dadalangx/neptune4max-autoprep/docs/hardware.md

**简体中文** | [English](hardware.en.md)

# 硬件与独立双 Z

准备配件和实际拆装前，先看[采购清单与装配步骤](bom-and-assembly.md)。这里保留驱动参数、引脚、参考几何与实物照片，供适配和标定时查阅。

## 已验证的组合

海王星 4 Max、ZNP K1 V2.0、MKS TMC2209 V2.0。两颗大采样电阻为 R110 时，电阻值是 **0.110Ω**，不是 110Ω，也不应把两颗相加为 0.220Ω。两颗分别服务电机相电流采样。

本机 E1 使用 UART 跳线，M0/M1/M2 开路，地址 0；`run_current: 0.6` 保持既有数值，`stealthchop_threshold: 0`。0.6A 是本机参考 RMS 电流，不是此驱动额定能力或所有电机的推荐值。核对实际模块版本、电阻丝印和插入方向，不能只凭芯片名称。

E1 跳线位置见实物图：**只短接 UART，M0/M1/M2 均留空**。照片为了展示跳线未插驱动模块，完成安装时需正确插入 MKS TMC2209 V2.0。

E1 UART 跳线设置实物

| 主板位置 | STEP | DIR | ENABLE | UART | 当前逻辑职责 |
|---|---|---|---|---|---|
| 原 Z | PC10 | PA13 | PC11 | PC5 | `stepper_z` |
| 新增 E1 | PB1 | PB2 | PB0 | PB6 | `stepper_z1` |
| E0 | PA5 | PA6 | PA4 | PC4 | 原挤出机；保留 |
| FAN2 | PB7 | — | — | — | 主模型风扇 |
| FAN3 | PC9 | — | — | — | 独立辅助模型风扇 |
| FAN4 | PA8 | — | — | — | 驱动专用散热风扇 |
| FAN1 / FAN6 | PC7 | — | — | — | 共用控制输出；改装后仅保留热端散热风扇 |

表格是不带取反符号的物理引脚。参考配置原 Z 为 `dir_pin: PA13`，E1 为 `dir_pin: !PB2`，使此前观察到的两侧正向运动均抬升；目标机器取反符号按实测设置。

## 装配

拆除 Z 同步皮带及丝杆顶部的两个同步带轮，使两侧可独立运动。将原来并联的电机线拆开，分别压接到原 Z 和 E1。保留每台电机的两组线圈配对，检查端子压接和接触，不按线色推断相序。断电后进行驱动、跳线和电机插拔。驱动需要散热片与主板风道。

辅助模型散热风扇复用海王星 4 Max 自带的风扇，无需另购，独立接 FAN3；匹配原接口的电压和极性，线长或接头不合适时按需准备配套线材。不能与 PB7 主风扇共用同一控制输出而期望 `P2` 单独调速。

驱动散热风扇从 FAN6/PC7 移到 **FAN4/PA8**。FAN1 与 FAN6 共用 PC7，将驱动风扇独立出来后，不再依赖热端温度启动。保持 FAN1 热端散热设置，检查 PA8 没有被其他配置占用，再合并 [driver_cooling.cfg](../config/reference/driver_cooling.cfg)。风扇、电机或模块接线均需先断电。

使用**拓竹 A1 适用的硅胶擦嘴条**，安装在**热床接线末端的塑料支架上**，位置参考下图。这类配件容易购买；不要把照片的目测位置当成坐标标定。实施者仍应测量自己的接触位置、高度、工具头间隙和全程行程，再生成擦嘴路径。

拓竹 A1 硅胶擦嘴条安装位置

## 左右映射及自动调平坐标

面对打印机正面定义左右。机主已确认参考机器为**原 Z 控制左侧，E1 控制右侧**。其他机器可能采用不同接法，**左右接线必须实测确认**：智能体应让机器旁的改装者观察小幅低速分轴测试，记录每个通道实际控制哪一侧以及正向是否抬升，不能直接套用参考机器的侧别。

这些运动测试必须遵守[上电/重启后的真实归位规则](validation.md#上电与重启后的归位规则)：先具备安全归位条件并完成真实G28，再进行后续XYZ运动。新增接线方向或空间条件尚不能确认时，先让用户检查，不能信任启动默认坐标或盲目归位。

`z_positions` 的第一行对应 `stepper_z`，第二行对应 `stepper_z1`。[Klipper 配置说明](https://www.klipper3d.org/Config_Reference.html#z_tilt)定义了这个顺序。正向抬升及实际运动侧必须先验证，再使用 Z_TILT；接反顺序会朝错误方向校正。

本机丝杆中心距实测 480 mm。绝对 X 原点未实测，历史参考用 430 mm 床宽居中估计为 -25 与 455；它们不是量产机械图纸尺寸。

| 观察到的映射 | `z_positions` 第一行 | 第二行 |
|---|---|---|
| 原 Z 左、E1 右 | `-25, 215` | `455, 215` |
| 原 Z 右、E1 左 | `455, 215` | `-25, 215` |

上表仅演示顺序，两列的数值仍需目标机器测量。回归测试没有替代电机接线和坐标验证。

六个探点是**喷嘴坐标**：左列 X70，右列 X400，Y184.55/194.55/204.55，采用蛇形顺序。对应参考 PA11 探针位置 X45.75/375.75，Y205/215/225，因为探针偏移为 X-24.25/Y+20.45。左右各三个点集中在中间约 20 mm 范围，避免前中后跨度过大。

## 排错入口

UART 无响应时先核对断电安装、插入方向、实际有无驱动、电阻/模块型号、UART 与 M0/M1/M2 跳线、PB6、地址 0 和供电。用 `DUMP_TMC STEPPER=stepper_z1` 判断通信，**通信成功不等于电机相序、侧别或方向正确**。未经确认不要反复执行归零或倾斜调整。

厂家资料：[MKS TMC2209 官方硬件说明](https://github.com/makerbase-mks/MKS-StepStick-Driver/tree/master/MKS%20TMC2209)。该资料说明的是模块本身；ZNP K1 的 UART 跳线组合来自机主这套实际组合的验证，不是所有主板的通用跳线规则。

## 接线和引脚参考图

原厂主板接线图，可用于识别电机、探针、加热器和风扇接口：

原厂主板接线图

ZNP K1 V2.0 引脚布局图，可用于核对 E1 的 PB6 UART、FAN4 的 PA8，以及 FAN1/FAN6 的共用 PC7 输出。原附件名称为“主板原理图”，图中展示的是引脚与接口布局：

ZNP K1 V2.0 主板引脚布局图
