dadalangx/neptune4max-autoprep/skills/neptune4max-mods/references/hardware-and-geometry.md

# 硬件和几何决策

准备采购或指导装配时读[采购清单与具体装配](../../../docs/bom-and-assembly.md)，按所选功能和目标机现状确认数量。4P胶壳/端子按实际重做的插头数计算，接口规格以匹配原插座为准；不要把市场“XH2.54”名称当作JST XH标称间距。辅助模型散热和驱动散热风扇均复用原厂件，按需准备改接线材。

适用基板是ZNP K1 V2.0。原Z: STEP PC10、DIR PA13、ENABLE PC11、UART PC5。E1: PB1、PB2、PB0、PB6。E0 PA5/PA6/PA4/PC4是挤出机，不分配给Z。

指定已用模块MKS TMC2209 V2.0；两颗R110各0.110Ω，不合并电阻；UART跳线闭合，M0/M1/M2开路，地址0。按实际模块而不是芯片家族核对。参考E1 dir_pin !PB2、原Z PA13、enable均取反、16细分、rotation_distance8、0.6A、threshold0；方向与电流不当成每台通用参数。

断电完成驱动、电机和跳线插拔，检查模块方向、供电、相线和压接。两根丝杆去掉同步皮带及顶部同步带轮后才可独立调节。

参考机器已由机主确认原Z控制正面左侧、E1控制右侧。复刻目标的接法可能不同：必须让机器旁的用户观察分别驱动的小幅低速测试，确认两个通道实际侧别和正向抬升后填写z_positions；观察不清不可猜，不因已有参考映射而跳过验证。

XYZ测试也受每次启动先真实归位的规则约束：先确认安全归位条件并完成本次启动的真实三轴G28，再执行后续分轴运动。未知接线方向、探针或空间条件应先由用户检查，不能信任默认坐标或盲目G28。详见项目docs/validation.md。

z_positions第一行对应stepper_z，第二行对应stepper_z1。参考间距480mm，原点用430床宽居中估计-25与455而非实测。参考探点喷嘴X70/400、Y184.55/194.55/204.55；探针偏移X-24.25/Y+20.45。范围、坐标原点和两侧机械位置需要目标校准。

FAN2 PB7为主[fan]，max_power0.70；FAN3 PC9独立auxiliary_fan，max_power1。M106默认/P0/P1主，P2辅助；M107无P关闭两者。仅改接线而没有P2宏路由或切片非零辅助风扇设置，不能完成Bambu控制。

FAN4 PA8为驱动专用controller_fan，原驱动风扇从FAN6 PC7移入。FAN1/FAN6共用PC7，保留热端heater_fan。监控X/Y/Z/Z1/挤出机使能，100% PWM，全部释放后延时60秒停；Z保持锁定时持续转是预期，不由M107关闭。空heater列表的旧版兼容见软件参考。

擦嘴条使用拓竹A1适用硅胶条，安装在热床接线末端塑料支架上；实物与UART跳线照片、两张接线/引脚参考图见项目docs/hardware.md。X10～30/Y430/Z-0.5、-2offset、高速200mm/s是参考路径。目标未测接触位置、高度或间隙时不要执行；生成自己的范围和接触高度。丝杆校准、清洁和耐高温胶带床高微调属于机械维护，不是固件自动矫直能力。
