dadalangx/neptune4max-autoprep/skills/neptune4max-mods/SKILL.md

---
name: neptune4max-mods
description: Adapt or troubleshoot the Neptune 4 Max ZNP K1 V2.0 modification project, including independent Z, ADXL nozzle offset, wiping, adaptive mesh with reference drift correction, Bambu fans and old Python compatibility. Use for this project’s replication or maintenance.
---

# Neptune 4 Max 改装接手

把本项目作为已使用改装机的工程参考，按用户所选功能适配目标机器。它不是经过原装全系列验收的一键安装包。准备发布材料不意味着授权修改机主正常运行的打印机；只读请求保持只读。

## 复刻流程入口

复刻或扩展功能时先读[总流程与依赖矩阵](references/replication-workflow.md)，确定目标机当前阶段和所选模块。总流程再指向[盘点、装配与部署步骤](references/deployment-and-integration.md)及[标定、切片与验收步骤](references/commissioning-and-calibration.md)，只读所处阶段及有关模块，按每阶段的输入、动作、完成证据和失败处理推进。

只排错或维护时从相关阶段开始；只整理资料时不进入机器部署。每台目标机保存私有接手记录，区分待测、模拟、计划、通信、接触和打印结果，跨会话继续前核对实时状态；不因记录写了“已完成”就自动重复实体动作。

复刻代码从[已有实现索引](../../docs/implementation-reuse.md)开始。`implementation-map.json`按功能列出精确配置节、源码、依赖与证据；在控制电脑运行`python tools/reference_bundle.py <功能ID>`只读取所选索引，`--config`可提取现成配置节。P2先复用这些实现，再合并目标差异；代码已经存在时不根据文字重写状态机、网格调度或风扇路由。该工具不安装，也不证明提取结果可直接加载。

## 开始时确认什么

读取用户提供的仓库 README、目标地址与任务范围。地址由用户自行确定，仓库不包含参考机IP；常见原厂SSH为mks/makerbase，用户修改后的凭据按其提供处理。如果skill被单独安装，先取得项目源码目录，再使用其中的source/config/patches，而不是以为skill含有全部程序。

先读取实际服务解释器、原厂版本、dirty源码、主板/模块型号、include与宏冲突。参考环境Klipper Python2.7.16、Moonraker Python3.7.3。保留目标原厂软件，默认不升级系统、Klipper、Moonraker或Python，不用改装机哈希充当原装白名单。`tools/preflight.sh`是可选只读盘点工具，不是安装器。

## 每次启动后的运动前置条件

每次打印机上电、G-code `RESTART` / `FIRMWARE_RESTART` 或Klipper进程/服务重启后，将真实归位状态视为未确认。原厂启动流程可能用`SET_KINEMATIC_POSITION`写入默认坐标；Ready、界面坐标和`toolhead.homed_axes`均不能单独证明真实归位。

执行后续任何XYZ移动前，必须先在已授权且归位路径、余量、探针及接线条件已确认的情况下完成真实三轴`G28`，并确认它成功结束。以本次启动内实际执行成功的归位记录或用户确认其已真实归位作为证据；不以写入坐标、强制移动或伪造homed标志替代。归位本身也是实体运动，条件不满足、归位失败或新增驱动方向尚无法确认时，停止后续移动并先协调用户检查，不盲目归位或先移动到猜测的安全位置。同一次启动内有效归位后可继续移动；再次重启就重新确认。

提醒用户：上电后尚未真实归位时，不要随意操作工具头移动，也不要点击网页端“校准床网补偿”按钮。首次双Z侧别/方向测试、擦嘴、探测及床网都遵守这条前置条件。只读盘点和不产生XYZ运动的风扇/寄存器检查不需要为了检查而自动归位。详见项目docs/validation.md的归位规则。

## 按任务读取资料

- 双Z、驱动、风扇或擦嘴：准备物料和装配时读[采购与装配指南](../../docs/bom-and-assembly.md)；配置或标定时读[硬件和几何](references/hardware-and-geometry.md)，再读项目docs/hardware.md与相关cfg。
- ADXL、床网、老Python或源补丁：读[软件和ADXL](references/software-and-adxl.md)，再读docs/software.md、docs/features.md及对应实现。
- 自适应/全床中心参考温漂修正：读[模块部署与验收](references/adaptive-mesh-drift.md)，再按需读项目docs/adaptive-mesh-drift.md；原生BED_MESH_CALIBRATE/G29不自动启用此项。
- 上线、排错、切片或回退：读[验证与切片](references/validation-and-slicer.md)，再读docs/validation.md、docs/slicer.md及相关的docs/lessons-learned.md经验条目。

只加载本次有关资料。按现有授权实施必要改动，不把其他模块或全机调参自动并入任务。

## 决策中保留的关键事实

1. MKS TMC2209 V2.0、R110 → sense_resistor0.110，E1 PB6 UART、地址0，UART跳线单独闭合。参考电流0.6A、threshold0。侧别/方向由实际观察决定；原Z不是E0挤出机通道。
2. `z_positions`顺序对应stepper_z、stepper_z1。参考机已由机主确认原Z左/E1右；每台复刻机器仍必须让用户协助小幅低速验证实际侧别和正向，不能根据参考布局直接推断目标接线。
3. PA11继续负责G28、床网和Z_TILT；ADXL仅做打印前offset。普通G28不自动校正双Z。wrapper在热稳定准备后、擦嘴/网格前校正。
4. Tap需要定制Linux MCU C和配套Python。参考机磁盘C是原版，但运行程序是Tap版；仓库source里的定制C来自原项目，不能用参考机磁盘原C重编译代替。
5. adaptive cfg的ADAPTIVE_MESH_RESOLVE由ADXL模块注册；仅选床网时需要独立适配注册入口。源码patch可能带厂商原有差异，比较后合并，不覆盖未知分支。
6. +0.140首层修正、擦嘴坐标、-2临时基线、PA11偏移、接触窗口、PID/PA/共振频率属于单机数据。
7. 驱动风扇由FAN6/PC7移至FAN4/PA8，controller_fan监控五个电机的使能/保持状态，全部释放后延时60秒关闭。heater留空；旧版需核对空列表过滤兼容。PC7热端风扇独立保留。

## 落地与结束

先在隔离本地目录准备逐文件差异及备份/回退清单，保留用户已有配置与保护。安装所选源码时按实际解释器和MCU协议验证；不复制整份printer.cfg、saved_variables或床网，不为实现冷拔而静默降低低温挤出保护。

运动、归零、风扇、加热、挤出和接触测试应符合用户授权，并在机器旁的用户已确认相关空间/硬件条件时执行。授权和条件已经明确则继续，不重复询问；条件缺失时先完成不依赖它的准备和只读检查。

控制与状态读取优先程序直接调用Moonraker API，减少浏览器页面操作；必要时通过SSH访问目标本机API，核对实际端口与认证，不把SSH视为所有机器必选通道。长命令与状态查询分开连接，具体按[通信经验](../../docs/lessons-learned.md#智能体控制优先直达-moonraker-api)选择。

长请求超时或SSH断开先查后端状态，不能盲目重发实体动作。通信、恢复位置、回抬或接触窗口异常时停止接触，不通过降低阈值、扩大窗口或更低Z下限伪造成功。

交付时说明具体修改、测试证据、备份位置及未完成的机械/首层验证。区分离线模拟、Ready/UART检查和真实打印成绩；未做第二台原装验证不能写“全系列兼容”。发布时仅导出所需文件，检查普通文本、3MF压缩成员与Git历史，排除实际IP、密钥、私有日志和备份。
