dadalangx/neptune4max-autoprep/docs/research/probe-drift-20261013/REPORT.md

**简体中文** | [English](REPORT.en.md)

# Neptune 4 Max 接近传感器时间漂移：实验记录与回应依据

实验日期：2026-10-13。整理日期：2026-10-15。**本资料是单台参考机的工程观察，不是传感器认证、全系列结论或优于所有既有方案的证明。** 本次仅重新分析历史记录，没有执行新实验。

## 可以怎样回应质疑

最有力的回应是：**在这台机器上，热床读数达到并保持目标，并不能保证接近探测系统的触发高度在随后数分钟内不再变化。短时间三次采样一致，也不等于整个扫描期间没有慢漂。** 这些判断有原始数据支持。中心参考时间插值在固定位置的独立样本上明显减少了相对初始基准的变化，因此不是完全未经测量的设想。

同时必须承认：没有测量探针本体温度，也没有独立的机械位移基准。记录包含传感器、支架、床面、龙门及运动系统的综合变化，尚不能把全部变化归因于探针芯片本身的电气温漂。单个参考点的代表性和真实床网的绝对精度仍需验证。

## 实验共同条件与数据来源

- Neptune 4 Max 一台；保留原厂 Klipper 分支，实验快照为 `v0.10.0-530-g3387a9c2-dirty`、Python 2.7.16。PA11 是主板输入引脚名，不是已鉴定的传感器型号。
- 热床目标 60°C，喷嘴目标 140°C。正式近床测量时主模型风扇和辅助模型风扇关闭；热端及驱动散热维持原自动逻辑。
- 固定点实验中，探针对应床面坐标 `(215,215)`；由于探针偏移为 X=-24.25、Y=20.45，喷嘴坐标为 `(239.25,194.55)`。
- 正式测量前建立真实归位基准；同一连续测试序列中不重新归位、不释放步进电机来重新定义基准。运行床网及临时 Z offset 在测试时清除，结束恢复。探测期间没有逐点修改全局 G-code Z offset。
- 升温、降温用单次 `PROBE` 观察曲线；5/8 分钟等待及参考插值试验均使用每组 3 次、取中位数，探测速度 8 mm/s、采样回升 3 mm、`samples_tolerance: 0.03`，保留原生重试规则。
- 这些漂移实验均未使用 ADXL，也未用喷嘴接触热床。因此本资料不能用来证明或否定 ADXL 接触测量的精度。
- [原始文件清单和 SHA256](source-manifest.json)记录了 12 份逐字节复制的 CSV；[重新计算脚本](reproduce.py)会验证哈希、原始三次采样的中位数、插值和统计值。不删除离群点。

床温、喷嘴温度是打印机已有温度传感器的读数，不是探针本体、床面所有位置或整机温度的直接测量。位置读数保留多位小数是为了复算，不表示相同量级的实际准确度。

## 实验一：靠近热床后的 15 分钟变化

热床连续处于 60±1°C 满 300 秒、喷嘴接近 140°C 后，真实归位、双 Z 调整及最后 Z 归位。探针保持床中心，工具头在 Z80，辅助风扇运行 60 秒后关闭 240 秒。回到 Z3，立即单次探测，作为本段基准。

此后 XY 固定，每约 15 秒先回升 3 mm 解除触发，再测一次，间隔期间留在触发高度附近。共 61 次，最后读数时间为基准后 903.276 秒。

| 指标 | 数值 |
|---|---:|
| 首次 / 末次触发 Z | -0.0975 / +0.1925 mm |
| 末次相对首次变化 | **+0.2900 mm** |
| 全段极差 | 0.3100 mm |
| 第约 63 / 123 / 303 秒相对基准 | +0.0725 / +0.1200 / +0.2175 mm |
| 正式采样床温范围 | **59.99～60.03°C** |
| 正式采样喷嘴温度范围 | 139.77～140.26°C |

这直接反驳“床已经到温，因此后续触发位置不可能明显变化”的说法。它没有证明这些数值全是传感器电气漂移，也不等于实际首层必然产生 0.29 mm 的间隙误差。

准备阶段曾因控制链路超时、记录器对旧版空床网的判断错误中断，并重新完成准备；中断轮次没有正式读数。因此此前累计加热时间长于一次冷机启动后只等待 300 秒，不能把本轮当作标准冷机实验。

## 实验二：远床停留为主的降温观察

保持 60/140°C 目标和相同机械坐标基准，不重新归位、不再调整双 Z。每次探测后回到 Z80，下一次测量前回 Z3 再探测；每约 15 秒一次，共 61 次、901.722 秒。主、辅助模型风扇均关闭。

首次触发 +0.1725 mm，末次 -0.0400 mm，**变化 -0.2125 mm**；趋势与近床保持相反。床温 59.68～60.09°C、喷嘴 139.76～140.55°C。

升温段清理曾短暂关闭加热，降温段恢复目标；两段首末探测间隔 32.314 秒，过渡期间触发值变化 -0.0200 mm。图中两段各用自己的基准，未拼接成无间断曲线。降温时必须周期性回床才能测量，所以它是**被探测动作打断的高位降温轨迹**，不是连续高位静置 15 分钟的纯降温曲线。

升温、降温与已有温度读数；英文图

近床与远床轨迹方向相反，支持“探测系统对远近床热历史敏感”的解释；仍不能排除机械热变形或其它与轨迹相关的因素。此前做过描述性指数拟合，但没有独立周期验证，不能把时间常数当成通用温漂补偿参数。

## 实验三、四：等待 5 分钟与 8 分钟是否足够

两轮采用同一名义预处理：Z100，辅助风扇全速 60 秒，关闭 300 秒；目标保持 60/140°C。回 Z3 单次触发，在该次触发位置附近分别静置约 300 秒、480 秒。随后回升，以独立三次中位数建立各自基准。

按当时首层测试文件的尺寸生成 9×10、共 90 个模拟点。**物理 XY 始终固定在床中心**；保留每点的实际 Z 探测动作，省略的横移用估算停顿代替。每点 3 次取中位数，共 270 次扫描下探。两轮均没有重试。

| 指标 | 等待 5 分钟 | 等待 8 分钟 |
|---|---:|---:|
| 实际近床静置 | 300.141 s | 480.391 s |
| 基准后最后一点时间 | 440.425 s | 439.073 s |
| 最大绝对基准偏差 | **0.0550 mm** | **0.0125 mm** |
| 90 个点中位数极差 | 0.0575 mm | 0.0175 mm |
| 末点相对基准 | +0.0475 mm | -0.0025 mm |
| 最大三次组内极差 | 0.0250 mm | 0.0250 mm |
| 扫描重试组数 | 0 | 0 |

**充分预热确实是有数据支持的简单方案。** 8 分钟这一轮比 5 分钟稳定，不能为了维护插值方案而忽略它。每种时长仅一轮，实际初始热状态未独立测量，尚不能保证“等 8 分钟任何情况下都够”。

两轮的三次采样都通过同一个 0.03 mm 容差，但 5 分钟轮仍缓慢移动，说明**组内一致性检查没有自动约束组间的长期漂移**。本轮分点通信、同步和记录使测量约耗时 440 秒，不能冒充真实连续 90 点床网的精确时长；原横移时长只是估计，横移气流和空间温差没有被复现。

5/8 分钟等待与组内极差；英文图

## 实验五：等待 3 分钟，每五点追加参考值

采用相同名义高位冷却预处理，实际近床静置 180.047 秒，之后独立三次中位数得到初始基准 B=+0.0300 mm。固定 XY，采集 90 个模拟网格样本；每五点后再进行一次独立三次参考测量，共 18 次追加参考。网格原始下探 270 次、追加参考下探 54 次；加上初到单次和初始基准，原始记录共 328 次。两类样本没有复用，重试均为 0。

初始参考时间为 0。参考 k 的变化 `D_k = R_k - B`。每个网格样本使用前后独立参考值、按实际日志结果时间做分段线性插值：

```text
D(t_i) = D_previous + (D_next - D_previous)
                       * (t_i - t_previous) / (t_next - t_previous)
Z_corrected(i) = Z_raw(i) - D(t_i)
baseline_residual(i) = Z_corrected(i) - B
```

所有样本位于参考值之间，没有外推；没有用这 90 个网格样本本身拟合漂移。统计对象是**独立网格样本**，不是把参考点减去自己。最后一个网格样本在 532.579 秒，最后参考值在 537.832 秒。

| 相对初始基准的指标 | 原始 90 点 | 统一扣组末参考 | 时间插值 |
|---|---:|---:|---:|
| 最大绝对偏差 | **0.122500 mm** | 0.015000 mm | **0.015427 mm** |
| 极差 | 0.117500 mm | 0.030000 mm | 0.022866 mm |
| RMSE | **0.082267 mm** | 0.005496 mm | **0.003133 mm** |
| 绝对偏差第 95 百分位 | 0.112500 mm | 0.012500 mm | 0.006693 mm |

最大绝对基准偏差在这一轮减少约 87.4%。这是相同原始数据的处理前后比较，避免了两轮起始状态不同的问题。仍有最大 +0.015427 mm 的残差，未删除；时间插值的最大残差略大于组末扣除法，因此不能声称每项指标都更优。

**这证明了固定点相对基准的一致性改善，不是独立真值意义上的床网精度提升证明。** 重复测量共用同一传感器和机械系统；参考随机误差会传播，相关误差也未被独立隔离。与 5/8 分钟轮相比，等待时间及采样节奏均变，不能把不同轮次的 RMSE 排成同条件优劣榜。

独立参考与修正残差；英文图

三种处理的同数据指标；英文图

## 实验六：实际 XY 床网集成验证

部署后真实归位并执行现有双 Z 调整，60/140°C，主、辅助模型风扇关闭。通过现有自适应入口，以模型边界 X/Y180～220、边距 10 mm，并保留接触标定所需的覆盖区域，得到 4×4 共 16 个实际空间测点。

近床实际保持 180.333 秒。初始中心参考 0.1350 mm；第 5、10、15、16 点后分别测参考，变化为 +0.0075、+0.0125、+0.0175、+0.0150 mm。最后不足五点的一组也有后参考。扫描与参考阶段为 72.495 秒。

历史验证核对了时间插值、16 个修正值到原生床网矩阵的蛇形映射和保存 profile 的连接。本次复算再次验证逐点 `raw - correction = corrected` 及参考时间插值。**真实横移可运行、矩阵连接正确，不等于证明矩阵更接近真实床形**；本轮没有独立真值或配对的未补偿空间扫描。

实际 XY 测试参考记录；英文图

## 对 Reddit 具体论点的判断

| 论点 | 可以据实回应的内容 |
|---|---|
| 床已到温，温漂补偿没有必要 | 床热敏电阻到温不等于探测系统热状态稳定。本机固定点在极窄床温读数范围内仍有大幅时间变化。适用结论限于本机和这套轨迹。 |
| 只有电容探针才会这样，现代电感探针无需考虑 | 不能凭传感器类别否定本机实测，也不能把本机变化推广为所有电感探针的普遍缺陷。此处没有探针本体温度与独立位移，合适名称是“与热历史相关的探测系统漂移”，而不是“已隔离证明的芯片电气温漂”。 |
| 调整采样容差并重试就足够 | 容差检查三次采样的局部一致性，并不比较相隔几分钟的各组中位数。增大数值会放宽筛选，减小数值会加强筛选；两者都不直接估计慢漂。若另外做跨足够时间的稳定性检查并等到稳定，确实是有价值的替代方案，8 分钟轮支持继续评估。 |
| 一次 Z probe 标定就解决了问题 | 静态 `z_offset` 校准可修正稳定偏差，不能单独消除测试过程中随时间变化的读数。这里不把动态床网修正与 ADXL 自动 offset 的有效性混为一项证据。 |
| 用一个点修整张床缺乏依据 | 合理质疑。现有固定点实验不能证明空间代表性；实际 XY 验证也未提供独立准确度真值。需要多参考点与重复空间扫描来检验。 |
| 不应取模型之外的床面区域 | 周期参考测量不是追加的空间网格节点，不被塞入床网矩阵。现有实现还会为中心附近的 ADXL 接触区域扩大覆盖，以便在接触点计算床网高度；它有额外耗时，并非任何自适应床网都必须这样做。 |
| Orca Direct Adaptive Bed Mesh 已解决这一切 | Orca 的直接自适应接口负责提供范围、点数、插值参数；本项目没有提供优于其原生流程的同条件 A/B 数据。选择测哪些 XY 点与判断相同 XY 的 Z 是否随时间改变，是可区分的测量问题。 |

## 算法成立的条件与风险

将测量简化为 `m(x,y,t) = h(x,y) + c(t) + l(x,y,t) + e`：h 是参考时刻床形，c 是各点共有的慢变分量，l 是位置相关的变化，e 是随机误差。中心参考插值主要估计 c，实际也会混入中心点自己的 l 和噪声。

如果中心处发生局部变化，而其它区域没有相同变化，扣除中心值反而可能把误差传播到其它点。算法不要求“所有床点物理热变形完全相同”，但若要改善整床测量，确实需要共同漂移占主要部分、局部差异足够小，且参考间隔足够短。**这些条件尚未全面验证。** 没有证据支持该算法替代机械修整、修好不稳定探针或省略正确标定。

代码层面可确认：当前[修正函数](https://github.com/dadalangx/neptune4max-autoprep/blob/468c40c689b60bea7c9cf67f59210503890fcade/source/klipper/klippy/extras/adaptive_mesh_drift.py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)保留 XY、修改传给原生床网的 Z 数值；[原生 finalize 调用](https://github.com/dadalangx/neptune4max-autoprep/blob/468c40c689b60bea7c9cf67f59210503890fcade/source/klipper/klippy/extras/adaptive_mesh_drift.py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)不包含参考点作为额外网格节点。漂移模块不发送 `SET_GCODE_OFFSET`。这只能澄清漂移算法的实现；独立的 ADXL 接触及 offset 工作流仍应单独评价。

## 与官方资料的关系

[Klipper Temperature Bias](https://www.klipper3d.org/Probe_Calibrate.html#temperature-bias)建议保持一致温度和充分等待，并给出在不重新归位、不释放电机的条件下比较冷、热探测的思路。本实验借鉴保留同一坐标基准的原则，但研究的是固定加热目标下改变远近床轨迹，不是对官方冷/热测试的原样复刻。该文档没有推荐本项目的中心时间插值算法，不能以此声称官方认可。

[Klipper probe 配置说明](https://www.klipper3d.org/Config_Reference.html#probe)区分采样次数、聚合方式、样本差值容差和超差重试。它没有把组内容差定义为跨整个床网的长期稳定性检测。该行为也已在当时机器使用的旧版 `probe.py` 中核对。

[OrcaSlicer 官方直接自适应说明](https://github.com/OrcaSlicer/OrcaSlicer/wiki/printer_basic_information_adaptive_bed_mesh)展示将范围和点数等交给 `BED_MESH_CALIBRATE`；[Klipper 自适应床网说明](https://www.klipper3d.org/Bed_Mesh.html#adaptive-meshes)讨论对象覆盖范围和测点缩放。这些资料没有构成本机单点漂移不存在的证据，也不证明本项目优于正常调校后的标准流程。

对方提供的 Neptune4.help 指南在本次核查时未能访问，因此不声称已读到其具体推荐参数，也不对该指南全文作反驳。上述判断依据已核对的官方说明和本机记录。[来源与访问范围](sources.md)给出链接及用途。

## 结论与尚欠的对照

**现有证据足以回应“没有观测、床到温就排除了漂移、组内容差自动消除慢漂”这几种绝对说法。它不足以支持“所有海王星 4 的电感探针都会有同样漂移”或“本方法已证明优于 Orca/长等待方案”。**

更稳妥的项目表述为：在一台 Neptune 4 Max 上观测到与热历史相关的触发高度变化；周期参考的时间插值在固定点独立样本中改善了相对初始基准的一致性；实际 XY 和原生床网连接已验证，空间准确度、重复性及与更简单方案的对照仍在评估。

后续若要证明更强的效果，应在同温度、板材、几何和采样参数下，重复并交错比较：充分等待后常规自适应测网、跨较长时间窗口的稳定性判断、以及较短等待加周期参考。需要多个不同位置的参考、可分离机械位移的独立测量，以及有统一评价方法的首层结果。应同时报告失败/重试次数、准备总时间及最好和最差循环，而不只挑漂亮的一轮。本次没有执行这些新测试。

## 复算

安装或使用已有兼容 Python 环境及 [requirements.txt](requirements.txt)，在本目录运行 `python reproduce.py`。脚本只读本地 CSV 并生成 `summary.json` 和英文 PNG/SVG，不连接打印机，不修改任何机器配置，也不发布资料。

提供的 12 个 CSV 均为原记录逐字节副本。重算包含 61+61 个单次读数、两轮各 90 个三次中位数、参考轮 90 个样本与 18 组追加参考，以及真实 XY 轮的 16 个测点/5 组含基准参考。正式结论与探索性阈值不应被误读为厂商规格。
