dadalangx/neptune4max-autoprep/docs/announcement.md

**简体中文** | [English](announcement.en.md)

# 发布文案

## GitHub 项目简介

Neptune 4 Max AutoPrep：海王星4Max打印准备自动化改进，包含独立双Z、自动Z偏移、A1硅胶条擦嘴、自适应床网、独立散热与Bambu Studio适配，提供源码、参考配置和AI skill。

## 中文发布帖

把自己的海王星4Max改装过程整理成了开源项目 **Neptune 4 Max AutoPrep**，围绕打印准备自动化分享给同样想折腾这台大尺寸打印机的朋友。

这套方案保留原厂工具头、热端、挤出机、电机和热床，在原厂软件环境上逐步增加独立双Z、打印前龙门校正、ADXL喷嘴接触测量Z偏移、硅胶条擦嘴、自适应床网、独立辅助风扇及驱动专用散热风扇。还整理了冷拔维护宏、主风扇比例映射、Bambu文件元数据适配，以及旧Python环境的兼容改动。

新增Z驱动统一为机主实际验证使用的MKS TMC2209 V2.0，主板E1只短接UART，R110模块使用0.110Ω采样电阻配置。接线、方向和调平坐标的确认方法都放在项目里。

擦嘴使用容易购买的拓竹A1适用硅胶条，安装在热床接线末端塑料支架上，项目已附实物照片和UART跳线照片，以及原厂接线与主板引脚图。参考机原Z控制左侧、E1控制右侧，每台复刻机器仍需实测自己的接线。驱动风扇改接FAN4，随电机通电散热，全部释放后延时60秒关闭。

分享方式是“改装思路＋源码＋参考配置＋AI skill”。你可以让Codex等智能体先读取项目和你的打印机环境，再按所需功能完成适配；无需先成为Linux专家，但硬件接线、首次接触和首层仍需要人在机器旁逐项确认。

项目提供我的Bambu Studio 3MF项目，以及独立的开始/结束G-code。打开项目即可查看和载入项目内设置，保存为自己的用户预设；其中单机擦嘴位置和首层修正需要重测。

目前完整组合来自一台实际使用的改装机，还没有在第二台原装4Max完成整套复刻验收。欢迎分享脱敏环境报告、接线照片、复刻结果和适配补丁，一起把支持范围做实。

项目：https://github.com/dadalangx/neptune4max-autoprep

## 首版发布说明

参考资料版，日期2026-10-12。内容包括：

- 硬件组合、引脚、驱动R110参数与侧别验证方法。
- ADXL定制Python模块、Linux MCU Tap C源码和固定基线补丁。
- 独立双Z、辅助风扇、驱动专用散热、冷拔、自适应床网参考配置。
- autotune旧Python兼容补丁、Moonraker元数据参考适配。
- Bambu Studio项目、首尾代码、AI skill和离线回归测试。

已清理发布副本的个人标识，不包含机主打印机IP、私有备份或日志。已提供A1擦嘴条安装及E1跳线照片；另一台原装机器整套验收尚未完成。
