dadalangx/neptune4max-autoprep/slicer/naptune4max.3mf

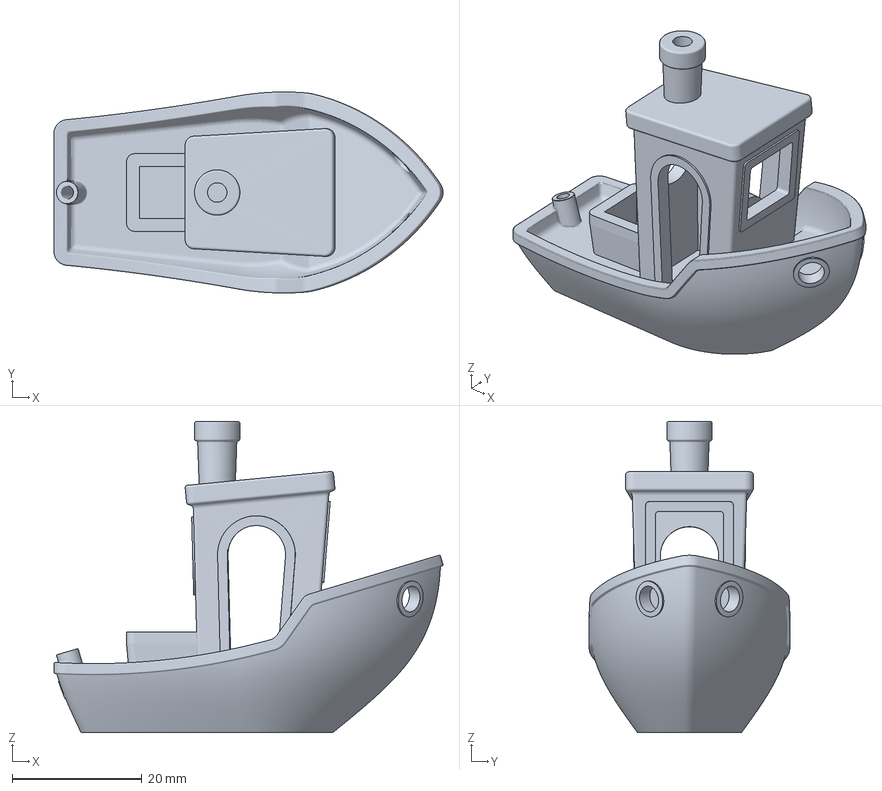
[picture p10: CAD file, 2026-10-12]
slicer/naptune4max.3mf
60.0 x 31.0 x 48.0 mm
