dadalangx/neptune4max-autoprep/docs/validation/adaptive-mesh-drift-20261013.md

**简体中文** | [English](adaptive-mesh-drift-20261013.en.md)

# 实机集成验证记录

完成时间：2026-10-13 05:48:29 UTC+8。结果：通过。

本轮验证的是实际 XY 扫描、中心参考插值和最终床网矩阵之间的连接。它不是对完整打印效果的测量，也不能据此宣称所有热误差均已消除。

## 实机流程

- 热床 60°C、喷嘴 140°C；主模型风扇、辅助风扇关闭。
- 部署重启后，先调用现有 DUAL_Z_LEVEL，完成真实 XYZ 归位与双 Z 调整。
- 使用原 ADAPTIVE_BED_MESH 接口，模型范围 X180～220/Y180～220、MARGIN=10，原边界解析器继续预留 ADXL 接触覆盖区。
- 生成 4×4 共 16 个实际网格点；中心参考位于热床坐标 (215,215)，本机对应喷嘴 (239.25,194.55)。
- 近床保持实际 180.333 秒，再独立三次探测取中位数为基准。
- 在第 5、10、15、16 点后追加三次探测取中位数；最后只有一点的一组同样得到前后参考值。
- 网格扫描及参考阶段约 72.495 秒，不含归位、加热和180秒保持。

## 中心参考记录

| 完成网格点数 | 相对基准时间/s | 参考中位数/mm | 相对初始参考/mm |
| --- | --- | --- | --- |
| 0 | 0.000 | 0.135000 | +0.000000 |
| 5 | 21.885 | 0.142500 | +0.007500 |
| 10 | 43.506 | 0.147500 | +0.012500 |
| 15 | 65.049 | 0.152500 | +0.017500 |
| 16 | 72.495 | 0.150000 | +0.015000 |

最大应用修正量：0.016660 mm。这里只扣除参考变化的时间插值量，网格的 XY 和真实空间高度差继续保留。

## 自动核对

- 逐点重新计算分段线性时间插值，与模块修正结果误差小于 1e-9 mm。
- 实际 bed_mesh.probed_matrix 的全部16个值与修正点按原蛇形扫描顺序映射后的结果一致，核对容差1e-6 mm（原生状态输出会取小数位）。
- 生成为独立测试 profile，后续恢复 default；未执行 SAVE_CONFIG。
- 10项离线测试在本地 Python 与本机 Python 2.7.16 均通过，包含90点/18次参考、原厂矩阵构建、Python2浮点除法、末组、真实归位和失败清理。
- 已验证原始备份、两个安装文件的 SHA256；原生 bed_mesh.py、probe.py、ADXL 模块等10个已快照文件内容未变。184个根目录 cfg 中仅 adaptive_bed_mesh.cfg 改变。

## 结束状态

工具头停在实际 Z10；热床、喷嘴加热目标为0；模型和辅助风扇关闭；恢复测试前 offset 与 default 床网。新模块保持加载，原 Bambu Studio 开始 G-code 中的 ADAPTIVE_BED_MESH 会自动使用此方法。

原始点和参考值分别在[网格数据](adaptive-mesh-drift-20261013-mesh-points.csv)与[参考数据](adaptive-mesh-drift-20261013-center-references.csv)。设备状态和部署记录中的 *.private.json 仅用于本地审计，发布时应排除。

## 方法选择前的固定XY实验

同一参考机，床60°C/喷嘴140°C，先远床降温（Z100、辅助60秒后关闭300秒），近床保持约180秒；在床中心取得90个独立模拟网格样本，每5点补一次独立三次中位数参考，共18次。XY实际保持固定，横向行程用模型停顿模拟，不是真实空间床网；这轮主要比较同一组原始数据修正前后。

| 指标/mm | 原始 | 时间插值修正 |
| --- | ---: | ---: |
| 最大绝对基准偏差 | 0.122500 | 0.015427 |
| 全段极差 | 0.117500 | 0.022866 |
| 相对基准RMSE | 0.082267 | 0.003133 |

没有删除最大偏差样本，也没有复用网格样本作为参考。实际XY横移、局部温度差和单点参考代表性尚不能从该实验推断；上面的4×4实测验证了集成和实际矩阵，后续重复性、不同模型范围/床温及首层打印仍需目标机验证。
