dadalangx/neptune4max-autoprep/skills/neptune4max-mods/references/validation-and-slicer.md

# 验证、切片和交付

按用户所选范围生成逐文件差异、备份及回退。机器写入保持空闲；若用户只要资料/只读，不重启、寄存器写入、运动或加热。已有授权与空间条件有效时继续，不要求重复批准同一动作。实体检查区分Ready、UART、真实侧别/方向、归零、接触、首层，不把代码模拟通过当实机验收。

智能体重复控制/读取状态优先直接调用Moonraker API，减少浏览器页面操作开销。网页代理超时或端口不能稳定直连时，通过SSH通道访问目标本机Moonraker；已稳定直连则不强制加SSH。先核对实际端口与认证，复用连接，长命令与状态查询用独立HTTP连接/channel；不因此开放端口或关闭认证。选择依据与示例见[通信经验](../../../docs/lessons-learned.md#智能体控制优先直达-moonraker-api)。

HTTP504或SSH断开不证明G-code终止；先查任务/状态，再决定，不能自动重发实体动作。正常接触失败按代码窄分类处理；下限/阈值/窗口不能作为泛用消错旋钮。

历史经验先按日期、当前源码和验证类别核对，不整份照搬交接记录。旧ADXL接管G28/床网、35/400或30/500等不是当前打印前路径；每个样本从PA11 coarse+5统一起步，当前25/300。低阈值离床误触和5kHz高重试/超时属于历史观测，不能包装成全系列结论。精选原因见项目docs/lessons-learned.md。

按时间顺序找第一个错误：PA校准曾因全床15×15耗时超过旧900秒会话而失败，关机后Lost communication只是后续。当前对显式PA段解析实际正挤出范围、参考TTL1800；先查无运动范围计划，不无限延长授权或重发接触。上一文件M204 S500也可能被下次继承；ADXL恢复进入探测时的加速度，结束代码需按目标基准恢复，不能把继承的500误判为300探测值泄漏。

每次上电、RESTART/FIRMWARE_RESTART或Klipper进程重启后，都重新确认真实归位；原厂默认坐标和homed_axes不足为证。先检查安全归位条件并确认本次启动真实三轴G28成功，再允许后续XYZ移动、分轴测试和床网；条件不满足或归位失败先协调用户检查，不盲目移动。提醒用户未真实Home时不要随意操作工具头移动，也不要点击网页端“校准床网补偿”。详细条件见项目docs/validation.md。

3MF项目保存于Bambu02.08.02.60，打开项目加载设置后另存用户预设，不只导入模型。+0.140是参考首层补偿，Y430擦嘴等几何需校准。最新版开始代码有Z2排料和回抽10mm，旧注释存在Z10描述；看真实指令。历史回归fixture的0.100首层修正与现文件0.140不同，不用旧fixture覆盖新用户文件。

首尾SET_SKEW在参考运行环境未注册，按目标实际情况生成适配模板。末尾;PRINT_END仅注释，M106S0仅关主风扇；已配置P2路由时使用M107或P2S0才关闭辅助。M84XYE保持正常结束时Z，取消/故障等路径可能释放，断电恢复尚未验证本方案完整状态恢复。

冷拔macro空闲保护，expanded维护gcode用于virtualSD。250度排料150mm/3mm每秒，辅助满开至110，关辅助到90，回抽30mm/1mm每秒，disableextruder、保持90，两声50%duty。温度配方需材料匹配；不得静默下调min_extrude_temp，参考70只说明为何90回抽可行。beeper占空比非听感比例，短响可以调小/关闭。旧RESPOND引号内分号也会截断，完成消息用and。

网页总层数来自MoonrakerBambu解析，当前层旧Fluidd估算，变层高/Zhop可能失真；不用未提供的SET_PRINT_STATS_INFO当已实现功能。

发布仅导出明确清单。可分享默认mks/makerbase，但实际IP由每位用户自行确定。检查源码/说明/配置、3MF压缩成员和Git历史的IP、密钥、设备/个人标识、日志和备份。保持GPLv3与模型出处；丝杆矫直、热床胶带补偿、清洁保养是机械维护经验，不宣传固件自动消除机械缺陷。
