dadalangx/neptune4max-autoprep/docs/validation/adaptive-mesh-drift-20261013-center-references.csv

after_point | seconds_from_baseline | median_z_mm | drift_from_baseline_mm
0 | 0.0 | 0.13500000000037948 | 0.0
5 | 21.884753988095326 | 0.14250000000266905 | 0.007500000002289564
10 | 43.506190630951096 | 0.14750000000509056 | 0.012500000004711076
15 | 65.04924892857161 | 0.15250000000778563 | 0.017500000007406147
16 | 72.49488033333364 | 0.1500000000085837 | 0.015000000008204228
