dadalangx/neptune4max-autoprep/docs/validation/adaptive-mesh-drift-20261013-mesh-points.csv

point | seconds_from_baseline | nozzle_x_mm | nozzle_y_mm | raw_z_mm | corrected_z_mm | applied_reference_drift_mm
1 | 3.7869714761891373 | 194.25000000065484 | 149.55000000065485 | 0.13250000000091955 | 0.13120218846986287 | 0.0012978115310566807
2 | 7.390679416666899 | 218.4093750003033 | 149.55000000065485 | 0.1700000000013322 | 0.16746718214685344 | 0.0025328178544787583
3 | 10.995782428570237 | 242.5703124999517 | 149.55000000065485 | 0.1575000000017397 | 0.1537316977268175 | 0.0037683022749221973
4 | 14.601983202381234 | 266.7296874996002 | 149.55000000065485 | 0.15000000000200142 | 0.14499583709887423 | 0.005004162903127191
5 | 18.210277500000302 | 266.7296874996002 | 169.5500000003638 | 0.15500000000240632 | 0.14875925901139542 | 0.006240740991010907
6 | 25.481532535713995 | 242.57031249995177 | 169.5500000003638 | 0.15250000000335806 | 0.14416823784558078 | 0.008331762157777284
7 | 29.10614594047547 | 218.40937500030338 | 169.5500000003638 | 0.17000000000376891 | 0.1608300388247174 | 0.009169961179051528
8 | 32.703005023808146 | 194.25000000065495 | 169.5500000003638 | 0.14000000000402935 | 0.1299982580454469 | 0.010001741958582444
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
