dadalangx/neptune4max-autoprep/docs/lessons-learned.md

**简体中文** | [English](lessons-learned.en.md)

# 精选调试经验

这里提炼项目调试记录中对复刻和排错有帮助的结论，并与本仓库的源码、配置和切片文件对照。原始记录混有不同日期的状态、已放弃的原型及临时参数，不能作为整份部署清单。未公开原始日志、机器地址或备份路径。

## 智能体控制优先直达 Moonraker API

重复控制与状态读取优先直接调用 Moonraker API，减少浏览器打开页面、等待渲染和点击控件的开销。页面适合用户观察和交互；智能体无需为了提交每条 G-code 或读取温度反复操作页面。这里区分的是**浏览器页面操作**与**程序直接调用接口**，不能把网页反向代理提供的 HTTP API 一概说成很慢。

本项目的温漂测试和床网集成验证采用已登录的 SSH 连接，通过 `direct-tcpip` 通道访问打印机本机 `127.0.0.1:7125` 的 Moonraker HTTP API。也可以建立 SSH 本地端口转发，或在打印机上通过 SSH 执行 HTTP 客户端。这能绕过网页代理，在长请求易出现 nginx 504、API端口无法直接访问或浏览器自动化开销较大时尤其有用；没有做各方式的延迟基准测试，不承诺 SSH 总是更快。

选择通道时先读取目标 Moonraker 的实际监听地址、端口和认证要求；7125是参考值。已能稳定直连且符合目标认证要求时，直接 HTTP/WebSocket API 也可以使用，不必强制增加 SSH。需要 SSH 转发时优先复用连接，只绑定控制电脑的 loopback；不为使用接口去开放公网端口、关闭认证或修改目标访问控制。认证信息留在私有会话中，不写公共记录。

OpenSSH 本地转发示例（另开终端保留连接；占位符替换为目标机地址，端口按目标调整）：

```sh
ssh -N -o ExitOnForwardFailure=yes -L 127.0.0.1:17125:127.0.0.1:7125 mks@<打印机地址>
```

控制电脑随后访问 `http://127.0.0.1:17125`，请求的是打印机端 Moonraker。先用无运动状态查询验证通道，例如 `GET /printer/objects/query?webhooks&print_stats&toolhead&extruder&heater_bed`；控制请求使用 `POST /printer/gcode/script` 与 JSON 请求体，而不是把任意 G-code拼进远端 shell 命令。

长命令单独提交，状态查询使用另一个 HTTP 连接/SSH channel，避免阻塞在同一个连接上。按任务时长设请求超时，观察后端状态、日志和模块进度；超时或 SSH 断开不能证明已经提交的动作停止，不自动重发归位、加热、挤出或探测。直达 API 不改变宏、加热及探测自身耗时，也不代替真实归位、现场条件和任务授权。

接口和完成语义以目标版本为准；Moonraker 官方的[G-code与状态接口](https://moonraker.readthedocs.io/en/latest/external_api/printer/)说明 `/printer/gcode/script` 在命令完成或报错时返回，[API概览](https://moonraker.readthedocs.io/en/latest/external_api/introduction/)区分 HTTP 与 JSON-RPC。本项目已验证上述旧版路径，不要求为了使用这些接口升级原厂软件。

## 历史方案与当前实现分开看

早期曾尝试让 ADXL 接管 G28 和整床网格，后来改为 **PA11 负责归零、床网和双 Z；ADXL 只负责打印前喷嘴 Z offset**。不要从旧记录恢复接管 G28 的 handler、宏或 ADXL 全床探测流程。

本仓库打印前配方为 25 mm/s、300 mm/s²、1.75g、20ms DUR、2kHz 轮询、120ms 武装延迟，每次 Tap 从同点 PA11 粗定位高度上方 5 mm 出发。旧记录中的 35/400、30/300、30/500 等是历史阶段值，不能单独摘出作为当前推荐。修改这组探测参数需同时检查配置、源码校验和相同配方的高位无接触检查，不能只改一个配置项。

历史条目标为“部署/状态确认”或“计划验证”时，不能改写成同版本真实接触或首层已验收。本仓库保留的配方与边界仍需目标机器校准，详见[验证证据及次序](validation.md)。

## 低阈值与更高轮询率未必更可靠

| 历史观察 | 对复刻的价值 |
|---|---|
| 在历史 35 mm/s、400 mm/s² 配方下，1.4375g 的高位无接触检查有 4/5 次误触发 | 电机运动振动也能触发传感器；喷嘴尚未碰床就触发时，不能把它当成成功接触。降低阈值并非通用漏触修复。 |
| 5kHz 历史整床 6×6 试验虽完成，36 点中有 10 点需要重测，共 14 组被拒绝、4 次通信超时 | 完成一次任务不足以证明稳定；当前保留 2kHz。轮询负载或调度裕量是可能解释，尚未独立证明。 |

这些是参考机在当时组合下的观测，不是所有打印机的物理极限。当前流程保留受控无接触检查、接触窗口、整组极差和有界重试；通信、回抬或位置恢复错误应先排查，不能通过更低 Z 下限、放宽接触窗口或降低阈值绕过。

## 三次接触要有一致的起始条件

早期第二、第三次 Tap 会从上一次触发后的回抬位置开始，与第一次的起始高度和行程不同。当前打印前路径在每次样本前关闭检测，以 5 mm/s 回到同组 `PA11 coarse_z + 5 mm`，等待运动完成、同步并确认坐标后再武装下探；内部重试也遵循相同条件。

这使三个样本按一致的运动条件比较。不能仅因旧 Tap 核心允许“从当前位置继续下探”，就绕过打印前模块的统一起点；更改后也不能以 Ready 代替接触重复性验收。相关日志为 `ADXL contact start: group=... sample=... raw_z=... PA11_coarse_z=...`。

## PA 校准超时要先看范围和第一个错误

一次 PA 线校准的切片范围被报成全床 0～420 mm，生成 15×15、共 225 个探点。床网完成时，旧的 900 秒擦嘴会话已过期，首个错误是 `Prepared nozzle-wipe session expired`；后续关机产生的 `Lost communication with MCU` 不是最初原因。

现在仅对明确 `PA_LINE_CALIBRATION_START/END` 段解析实际正向挤出线段，普通模型仍使用切片包围框。参考配置将会话有效期设为 1800 秒，保留同文件、同床温、打印状态和单次使用检查，不改成无限期授权。历史失败文件的局部 6×5 结果做过计划验证，不能把这项证据写成修复后的真实碰床验收。

遇到类似错误，按时间顺序找第一个失败，再核对实际文件范围、计划网格及耗时。先用不运动的范围计划检查，不能反复重发完整开始流程；详见[自适应床网](features.md#自适应床网)。

## 上一任务的加速度可能影响下一次打印

历史单层文件留下 `M204 S500`，结束流程未恢复基准，使下一任务开始时的 `toolhead.max_accel` 仍为 500。ADXL 临时使用 300 探测加速度，结束后恢复的是**进入探测时的值**；恢复到 500 不代表探测加速度泄漏，也不代表它会自动读取配置中的 2000。

仓库当前结束代码在停车前显式恢复参考运动基准，再等待停车完成。为另一台机器生成模板时使用它自己的基准，核对实际 3MF 预设和生成 G-code；中断跳过正常结束流程时，也应检查继承状态。历史起止模板不能直接替代机主最新文件。见[切片适配](slicer.md)。

## 老版本接口要对照实际对象和进程

旧 Klipper 中的 `heater_bed` 可能是包装对象，温度接口在其底层 Heater 上。历史上直接对包装对象调用 `get_temp()` 曾引发内部命令错误；当前等待函数兼容直接 Heater、`.heater` 和 `get_heater()`，无须以升级 Python 或整套固件代替接口适配。

修改 Python 模块后，G-code `RESTART` 不能单独证明新源码已重新导入。按实际服务关系重启 Klipper 进程，核对进程身份/启动时间、加载状态及 Ready；新的配置或状态确认仍不等于机械接触验收。每次重启后的真实归位规则照常适用。Linux MCU 程序、配套 Python 模块与配置须一起检查，详见[软件适配](software.md)。

300 秒连续热稳定及随机接触点属于当前功能，已在[工作原理](features.md)说明其日志、计时条件与分散局部接触的目的；不将历史参数扫描和全量调试记录混入日常操作流程。
