dadalangx/neptune4max-autoprep/config/reference/print-exit-macros.cfg

# Existing PRINT_END / CANCEL_PRINT macros, excerpted from the reference printer.
# These include factory PLR integration: SAVE_VARIABLE, RUN_SHELL_COMMAND
# CMD=clear_plr, and clear_last_file. Preserve the target's existing handlers;
# merge only the relevant changes after checking these dependencies.
# They release Z through M84; the supplied slicer end code uses M84 X Y E instead.
# This file is a reference excerpt, not an additional include for an existing macro.
# No new execution of these exit paths was performed for this export.
[gcode_macro PRINT_END]
gcode:
    SAVE_VARIABLE VARIABLE=was_interrupted VALUE=False
    RUN_SHELL_COMMAND CMD=clear_plr
    clear_last_file
    {% set RUN_VELOCITY = printer.configfile.settings['printer'].max_velocity|float %}
    {% set RUN_ACCEL    = printer.configfile.settings['printer'].max_accel|float %}
    {% set RUN_DECEL    = printer.configfile.settings['printer'].max_accel_to_decel|float %}
    SET_VELOCITY_LIMIT VELOCITY={RUN_VELOCITY} ACCEL={RUN_ACCEL} ACCEL_TO_DECEL={RUN_DECEL}

    M220 S100
    M221 S100
    {% set z = params.Z|default(100)|int %}
    {% if (printer.gcode_move.position.z+5) < z %}   #If the current gcode-Z position is less than the maximum limit position
      G90 							            ; absolute positioning
      G1 Z{z+5} F6000 				      ; park nozzle at rear
    {% endif %}
    TURN_OFF_HEATERS
    M107
    M84

[gcode_macro CANCEL_PRINT]
rename_existing: BASE_CANCEL_PRINT
gcode:
      SAVE_VARIABLE VARIABLE=was_interrupted VALUE=False
      RUN_SHELL_COMMAND CMD=clear_plr
      clear_last_file
      {% set RUN_VELOCITY = printer.configfile.settings['printer'].max_velocity|float %}
      {% set RUN_ACCEL    = printer.configfile.settings['printer'].max_accel|float %}
      {% set RUN_DECEL    = printer.configfile.settings['printer'].max_accel_to_decel|float %}
      SET_VELOCITY_LIMIT VELOCITY={RUN_VELOCITY} ACCEL={RUN_ACCEL} ACCEL_TO_DECEL={RUN_DECEL}
      {% set z = params.Z|default(100)|int %}
      {% set x_park = params.X|default(printer.toolhead.axis_minimum.x+5)|int %}
      {% set y_park = params.Y|default(printer.toolhead.axis_maximum.y-5)|int %}
      SET_IDLE_TIMEOUT TIMEOUT={printer.configfile.settings.idle_timeout.timeout}
      SDCARD_RESET_FILE
      M220 S100
      M221 S100
      M400 							            ; wait for buffer to clear
      G91 							            ; relative positioning
      M83 							          ; zero the extruder
      G1 E-10.0 F1200 				      ; retract filament
      TURN_OFF_HEATERS
      M107 							            ; turn off fan
      {% if (printer.gcode_move.position.z+5) < z %}
      G90
      G0 X{x_park} Y{y_park} Z{z+5} F6000
      {% endif %}
      {%if (printer.gcode_move.position.z+5) >= z %}
      {%if (printer.gcode_move.position.z+5) < printer.toolhead.axis_maximum.z %}
      G91 							            ; relative positioning
      G1 Z5 F300
      G90
      G0 X{x_park} Y{y_park} F6000 				      ; park nozzle at rear
      {% else %}
      G90
      G0 X{x_park} Y{y_park} Z{printer.toolhead.axis_maximum.z} F6000 				      ; park nozzle at rear
      {% endif %}
      {% endif %}
      M84
