dadalangx/neptune4max-autoprep/(commit log)

2026-10-12 Publish Neptune 4 Max modification sources, Bambu project and AI handoff skill
    [adaptive_bed_mesh.cfg, adxl345_z_offset.cfg, bambu_aux_fan.cfg, cold_pull.cfg, host-sensors-motors.cfg, independent_dual_z.cfg, motor_database.cfg, naptune4max.3mf]
2026-10-12 Add dedicated driver cooling and illustrated hardware guidance
    [driver_cooling.cfg, independent_dual_z.cfg, printer-sections.cfg]
2026-10-12 Require real homing after startup or Klipper restart before XYZ movement
2026-10-12 Add English default README with Chinese language switch
2026-10-12 Use Chinese by default with an English README language switch
2026-10-12 docs: explain heat soak and randomized contact; curate debugging lessons
    Clarify the continuous 300-second bed stabilization timer and the single randomized XY point used by all contact samples. Add selected historical failure causes and current design rationale, with matching Chinese/English README and AI skill references.
2026-10-12 docs: simplify user README and add staged agent replication workflow
    Make the Chinese and English READMEs focus on downloading, using an agent, and importing the adapted Bambu preset. Route the skill through a top-level workflow, deployment steps, and commissioning procedures with feature dependencies, stage evidence, failure handling, and resumable target records.
2026-10-12 Add center-reference drift correction for adaptive bed meshes
    Hold near the bed for 180 seconds, add independent three-sample median references every five mesh points, and correct each block using time interpolation. Keep native BED_MESH_CALIBRATE and G29 behavior unchanged.
    Publish the Python 2 compatible module, config integration, staged agent instructions, offline tests, and sanitized fixed-XY and actual 4x4 validation evidence. All 68 offline tests pass.
    [adaptive-mesh-drift-20261013-center-references.csv, adaptive-mesh-drift-20261013-mesh-points.csv, adaptive_bed_mesh.cfg]
2026-10-12 docs: add parts list and detailed hardware assembly guide
    Publish the reviewed guide covering dual Z wiring, the A1 wiper, factory fan reuse, tools, and assembly checks. Link it from both READMEs and the agent procurement and assembly workflow.
2026-10-12 docs: add English editions of reader-facing guides
    Translate parts, hardware, features, software, slicer, validation, drift correction and test records, lessons, announcements, contribution and source notes. Add language switches and route the English README to English guides, retaining the Chinese agent workflow and all technical settings.
2026-10-12 Add feature-level reuse map and existing printer exit macros
    Map working-reference implementations to exact source/config sections so agents reuse existing code before adapting target differences. Add a local read-only section reader, bilingual reuse guide, and unchanged PRINT_END/CANCEL_PRINT implementations from two captured printer configurations.
    Validation: 75 offline tests, skill validator, 269 relative links/anchors, artifact hashes and snapshot comparisons. No printer connection or changes. Document standalone resolver and MCU rebuild validation limits.
    [print-exit-macros.cfg]
2026-10-14 docs: publish probe drift experiments, data and English figures
    [interrupted-cooling.csv, real-xy-center-references.csv, real-xy-mesh-points.csv, reference-180-block-constant.csv, reference-180-interpolated.csv, reference-180-points.csv, reference-180-raw-probes.csv, wait-300-points.csv]
2026-10-14 Sync owner-validated Z tilt tolerance and travel speed
    [independent_dual_z.cfg]
